RubenvanTonder/azoteq-logic-analyzer/pcb/A1/Reports/DRC/DT_AZP1524A1_PCB1_00A.html

Altium

# Design Rule Verification Report

Date: | | 2026/04/16
Time: | | 09:55:09
Elapsed Time: | | 00:00:00
Filename: | | C:\Users\Jason Reinecke\Desktop\AZP1524\A1\DT_AZP1524A1_PCB1_00A.PcbDoc

Warnings: | | 0
Rule Violations: | | 0

## Summary

Warnings | Count
Total | 0

Rule Violations | Count
Clearance Constraint (Gap=0.35mm) (((ObjectKind = 'Track') or (Objectkind = 'Arc')) And (Layer = 'KeepOutLayer') And (Width = AsMM(0.005))),(All) | 0
Clearance Constraint (Gap=0.3mm) (Innamedpolygon ('Top-GND') or Innamedpolygon ('Bot-GND')),(All) | 0
Clearance Constraint (Gap=0.1mm) (isvia),(onsoldermask) | 0
Clearance Constraint (Gap=0.2mm) (All),(All) | 0
Clearance Constraint (Gap=0.8mm) (hasfootprint('TEST-POINT-1.5MM')),(hasfootprint('TEST-POINT-1.5MM')) | 0
Clearance Constraint (Gap=0.5mm) ((ObjectKind = 'Track') And (Layer = 'KeepOutLayer') And (Width = AsMM(0.01))),(All) | 0
Short-Circuit Constraint (Allowed=No) (All),(All) | 0
Un-Routed Net Constraint ( (All) ) | 0
Power Plane Connect Rule(Relief Connect )(Expansion=0.5mm) (Conductor Width=0.35mm) (Air Gap=0.25mm) (Entries=4) (Disabled)(Ispad) | 0
Power Plane Connect Rule(Direct Connect )(Expansion=0.508mm) (Conductor Width=0.254mm) (Air Gap=0.254mm) (Entries=4) (Disabled)(Isvia) | 0
Hole Size Constraint (Min=0.3mm) (Max=4mm) (Disabled)(All) | 0
Hole To Hole Clearance (Gap=0.3mm) (All),(All) | 0
Silk To Solder Mask (Clearance=0.1mm) (isdesignator),(onsoldermask) | 0
Net Antennae (Tolerance=0mm) (All) | 0
Vias Under SMD Constraint (Allowed=Not Allowed) (All) | 0
Total | 0
