RubenvanTonder/azoteq-logic-analyzer/maximum square wave frequency measurable.jpeg

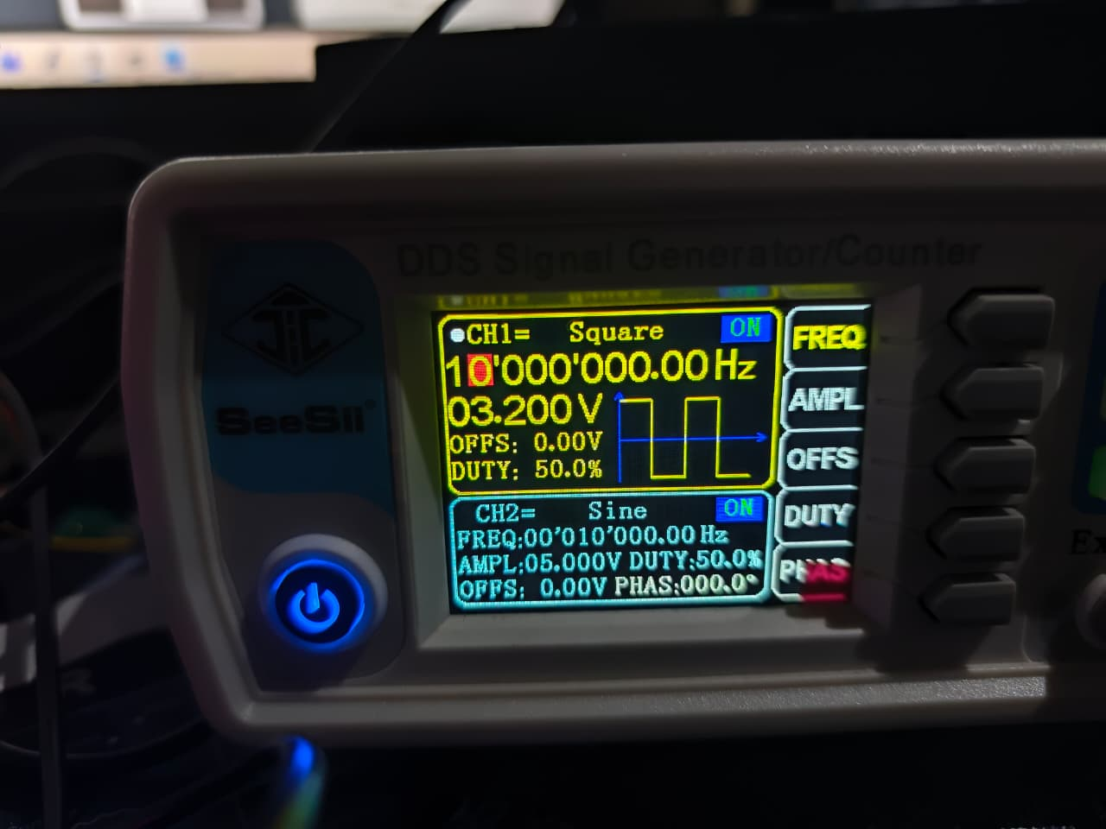
maximum square wave frequency measurable.jpeg
