RubenvanTonder/azoteq-logic-analyzer/Photos/75ns.png

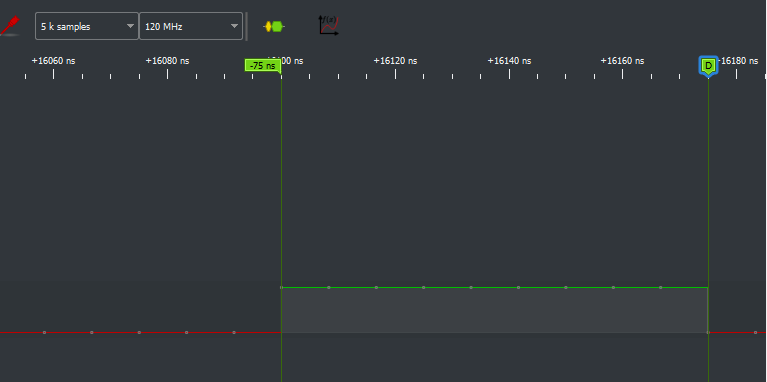
Photos/75ns.png
