RubenvanTonder/azoteq-logic-analyzer/Photos/166ns.png

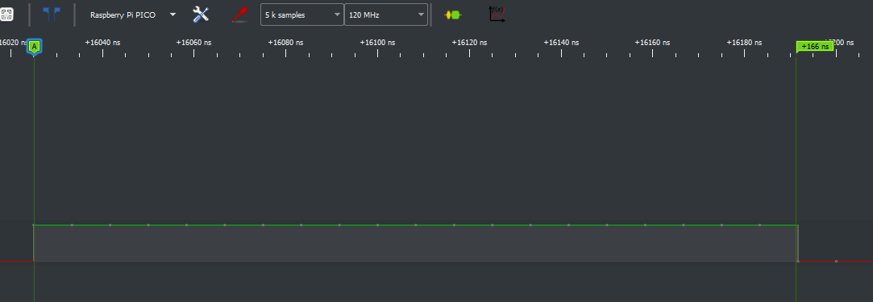
Photos/166ns.png
