RubenvanTonder/azoteq-logic-analyzer/Photos/268ns.png

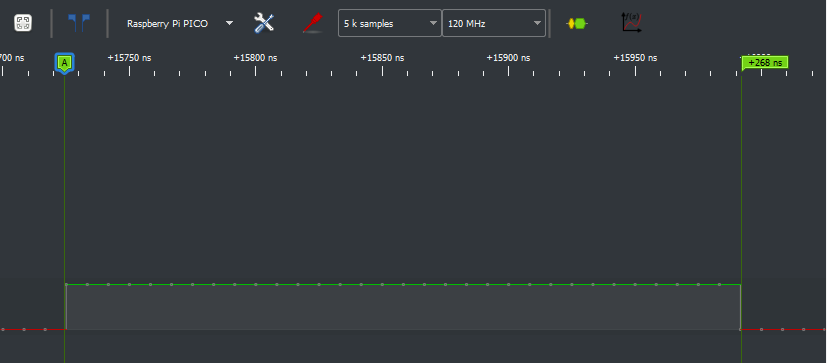
Photos/268ns.png
