RubenvanTonder/azoteq-logic-analyzer/Photos/368ns.png

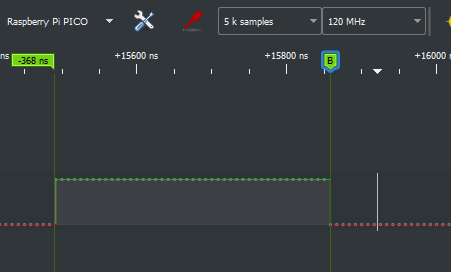
Photos/368ns.png
