RubenvanTonder/azoteq-logic-analyzer/Photos/470ns.png

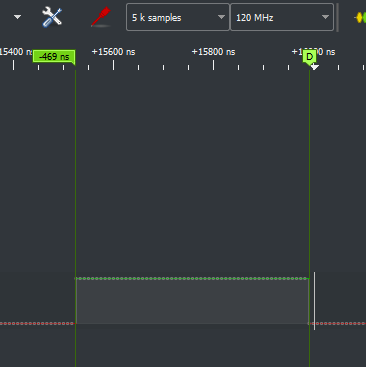
Photos/470ns.png
