RubenvanTonder/azoteq-logic-analyzer/trigger_level.jpeg

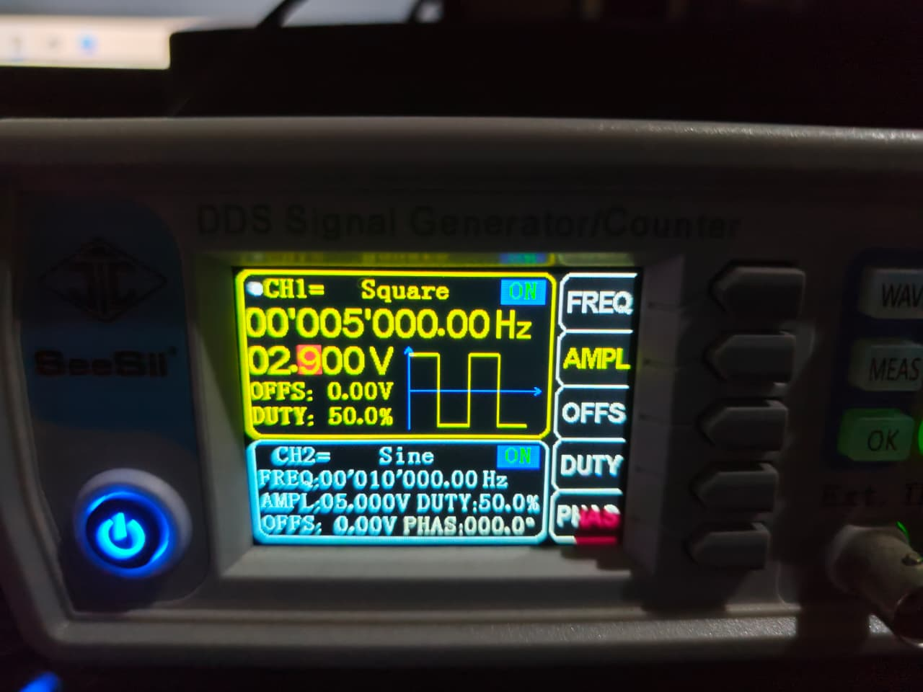
trigger_level.jpeg
