RubenvanTonder/azoteq-logic-analyzer/pcb/A1/Reports/BOM/BOM/[Bill of materials]-AZP1524A1.xlsx

Name | Description | Designator | Footprint | Int_Part_Number | LibRef | Quantity | Manufacturer | Manufacturer_PN | Layer
1uF | Capacitor, Ceramic, 1uF, 0603, X5R, 10%, 10V | C1, C4, C6, C7 | C-0603 | CAP0021 | CAP 1u0F 0603 CER X5R 10% 10V | 4 | Samsung | CL10A105KP8NNNC | Top
10uF | Capacitor, Ceramic, 10uF, 0603, X5R, 20%, 6V3 SAMSUNG | C2, C5 | C-0603 | CAP0076 | CAP 10uF 0603 CER X5R 20% 6V3 SAMSUNG | 2 | SAMSUNG | CL10A106MQ8NNNC | Top
100nF | Capacitor, Ceramic, 100nF, 0603, X7R, 10%, 50V | C3 | C-0603 | CAP0032 | CAP 100nF 0603 CER X7R 10% 50V | 1 | Samsung | CL10B104KB8NNNC | Top
NSR0320MW2T1G | Diode Schottky 20V 1A 2-Pin SOD-323 T/R | D1 | D-SOD-323 | DIO0074 | Diode Schottky 20V 1A SOD-323 | 1 | ONsemiconductors | NSR0320MW2T1G | Top
LM4041DID |  | D2 | SOT-23 |  | DIODE-ZENER-LM4041-SOT-23 | 1 | Texas Instruments | LM4041DIDBZTG4 | Top
KPT-1608ID |  | DS1 | D-LED-RED-0603 |  | LED-KPT1608ID-RED-0603 | 1 | KingBright | KPT-1608ID | Top
WEJT61BC-D76 | LED, WEJT61BC-D76, Blue, Vf=3.2V , If=30mA | DS2 | D-LED-BLUE-0603 - WEJ updated | LED0098 | LED-WEJT61BC-D76-BLUE-0603 | 1 | WEJ | WEJT61BC-D76 | Top
USB4500-03-0-A | USB-C TYPE REC 16P, 3U" MID MNT 0.8MM USB2.0 | J1 | J-USB-GCT-USB4500-03-0-A | NONE | USB-GCT-USB4500-03-0-A | 1 | GCT | USB4500-03-0-A | Top
HEADER-10W | Connector, Header, Edge Mount,DIL, 10W, SMT | P5 | P-BERG-10W-HDR-EDGE |  | BERG-10W-HDR-EDGE | 1 |  |  | Top
8W-SIL-RA | Connector, Header, Right angle, SIL, 8W, THP | P6 | P-BERG-8W-HDR-RA-SIL |  | BERG-8W-HDR-RA-SIL | 1 | Ho Chien |  | Top
AZP1524A1 | PCB | PCB1 |  | MNFPCB | PCB - AZCxxxA01 | 1 |  | AZP1524A1 | None
 | Resistor, 0603, 5%, 0.1W | R1, R3, R5, R6, R8 | R-0603 | MNFR04 | MNFR 0603 5% 0.1W | 5 |  |  | Top
DNP | Resistor, DNP, 0603 | R2, R7, R9, R10, R13 | R-0603 | DNP | RES DNP 0603 | 5 |  |  | Top
470R | Res Thick Film 0603 470 Ohm 5% 0.1W(1/10W) ±100ppm/°C Molded SMD Paper T/R | R4 | R-0603 | RES0307 | RES 470R 0603 5% 0.1W Yageo | 1 | Yageo | RC0603JR-07470RL | Top
0R | Res Thick Film 0603 0 Ohm Molded SMD Paper T/R | R11 | R-0603 | RES0139 | RES 0R 0603 1% 0.1W Yageo | 1 | Yageo | RC0603JR--070R | Top
0.5A POLYSWITCH | Polyswitch, nanoSMDC050F, 1206, 0.5A, 13.2V | R12 | R-POLYSWITCH-1206 | SWT0070 | POLYSWITCH-nanoSMDC050F/13.2 | 1 | Tyco | nanoSMDC050F/13.2 | Top
5K1 | Resistor, 0603, 1%, 0.1W | R14, R15 | R-0603 | MNFR03 | MNFR 0603 1% 0.1W | 2 |  |  | Top
22R | Resistor, 0603, 1%, 0.1W | R16, R17 | R-0603 | MNFR03 | MNFR 0603 1% 0.1W | 2 |  |  | Top
GABOU-KFC-807 | SWITCH TACTILE SPST-NO 0.05A 12V | S1 | S-GABOU-KFC-807 |  | GABOU-KFC-807 | 1 | GABOU | KFC-807 | Top
OS103011MS8QP1 | SWITCH SLIDE SP3T 100MA 12V | S2 | S-C&K-OS103011MS8QP1 |  | C&K-OS103011MS8QP1 | 1 | C&K | OS103011MS8QP1 | Bottom
AZP1159C1 | AZP115C01: RP2350 Stamp (Pi Pico) - stamp breakout | U1 | AZP1159C1 | NONE | AZP1159C1 | 1 | Azoteq | AZP1159C1 | Top
AMS1117-3.3V | IC, Voltage Regulator, 3.3V Out, 4.7-18V In, 1A | U2 | SOT-223 | NONE | AMS1117-MSKSEMI-SOT-223 | 1 | MSKSEMI | AMS1117-3.3V | Top
AP2138N-1.8TRG1 | IC REG LINEAR 1.8V 250MA SOT23-3 | U3 | SOT-23 |  | AP2138N-1.8TRG1-SOT-23 | 1 | Diodes Incorporated | AP2138N-1.8TRG1 | Top
SN74LVC8T245PW |  | U4 | U-TSSOP-24 |  | SN74LVC8T245PW-TSSOP-24 | 1 | Texas Instruments | SN74LVC8T245PWG4 | Top
