RubenvanTonder/azoteq-logic-analyzer/pcb/A1/CAD/STEP & PARASOLID FILES/DT_AZP1524A1_PCB1_00A.step

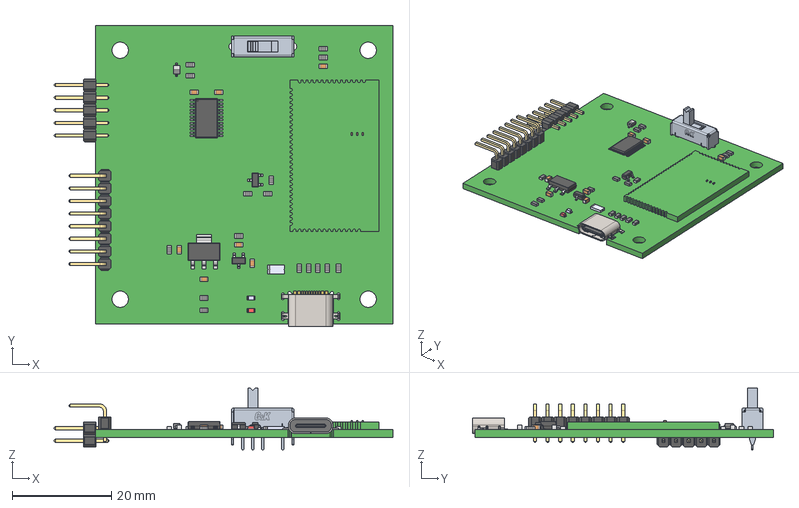
[picture p13: CAD file, 2026-05-11]
pcb/A1/CAD/STEP & PARASOLID FILES/DT_AZP1524A1_PCB1_00A.step
68.3 x 60.7 x 12.5 mm
R-0603 x 16
USB4500-C_Body
USB4500-C_ConnPlate
USB4500-C_Pins
U-TSSOP-24
User_Library-Chip_Cap_MLCC_0201_(0603) x 3
SOT-23 x 2
SW3DPS-SOT-223-DEFAULT
OS103011MS8QP1
R-POLYSWITCH-1206
P-BERG-8W-HDR-RA-SIL
P-BERG-10W-HDR-V
D-LED-0603-BLUE
D-LED-0603-RED
SOD-323
C-0603 x 7
