RubenvanTonder/azoteq-logic-analyzer/(list of files, cad)

Other CAD files:
pcb/A1/CAD/STEP & PARASOLID FILES/DT_AZP1524A1_PCB1_00A.DXF
pcb/B1/CAD/STEP & PARASOLID FILES/DT_AZP1524A1_PCB1_00A.DXF
