RubenvanTonder/azoteq-logic-analyzer/Functional Tests.docx

1. Maximum Sample Rate Test

Verify the highest speed at which the hardware can reliably capture data without dropping bits.

- Method: Input a high-frequency square wave (e.g., from a signal generator).
- Goal: Ensure the captured waveform matches the input frequency without aliasing.
- Check: Verify the Shannon-Nyquist limit (sample at least 2x the input frequency). [1 (https://jpowcode.github.io/Basic%20functions.html)]

2. Pulse Width & Glitch Capture

Test the minimum pulse width the analyzer can detect. [1 (https://www.vinnie.work/docs/EmbeddedSystemsAnalysis/HardwareSignalsAnalysis/SerialAccessLab)]

- Method: Input a series of narrowing pulses (100ns, 50ns, 10ns, etc.).
- Goal: Identify the "blind spot" where the hardware fails to register a transition.
- Check: Confirm if the hardware can capture pulses shorter than the sample period. [1 (https://knimbus.wonderslate.com/wpmain/aibook?siteName=Wonderslate&bookId=95867)]

3. Multi-Channel Skew Test

Check for timing alignment issues between different input pins.

- Method: Send the same fast clock signal to all input channels simultaneously.
- Goal: Measure the time delta between the first and last channel registering the edge.
- Check: Ensure skew is within your design's tolerance (ideally <1 sample period).

4. Trigger Latency & Reliability

Ensure the analyzer starts recording exactly when the trigger condition is met. [1 (https://www.oemsecrets.com/articles/oscilloscopes-essential-tools-for-electrical-signal-analysis)]

- Method: Set a complex trigger (e.g., a specific I2C address or pattern) and measure the offset.
- Goal: Confirm the "trigger point" in the buffer aligns with the actual event.
- Check: Test "Pre-trigger" and "Post-trigger" buffer depth accuracy. [1 (https://articles.saleae.com/logic-analyzers/what-is-a-logic-analyzer), 2 (https://www.switchdoc.com/2019/10/using-a-logic-analyzer-for-fun-and-profit-raspberry-pi/)]

5. Threshold & Logic Level Stress

Validate the comparator or input buffer performance across voltage ranges.

- Method: Use a variable voltage source to find the exact high/low transition point.
- Goal: Verify the switching threshold matches your design (e.g., 1.8V, 3.3V, or 5V logic).
- Check: Test for "double-triggering" or noise on slow-rising edges (hysteresis check). [1 (https://docs.amd.com/api/khub/documents/ySaQRCY6Y5vUd8bI_TWSug/content)]

6. Sustained Data Throughput

Check for buffer overflows or USB/Interface bottlenecks.

1. Method: Capture a high-speed data stream (like an SPI flash read) for several seconds.
2. Goal: Ensure no data gaps occur during long-duration captures.
3. Check: Monitor for "Buffer Overflow" errors in your software or FPGA logic.
1. Maximum Sample Rate Test

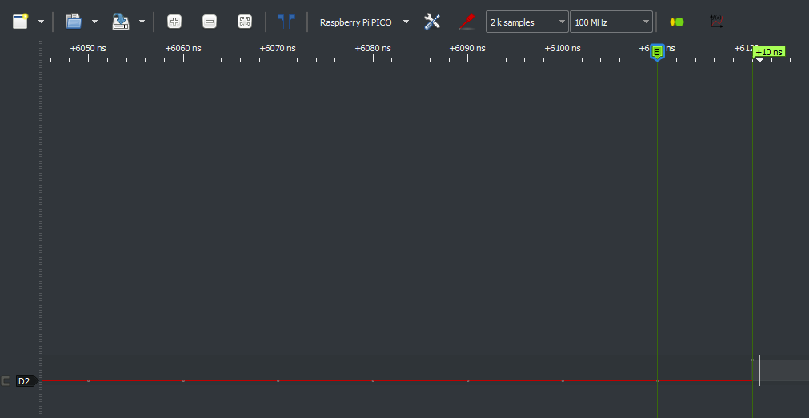
[picture p14: figure]

2. Threshold and Logic Trigger


3. Minimum Pulse Width

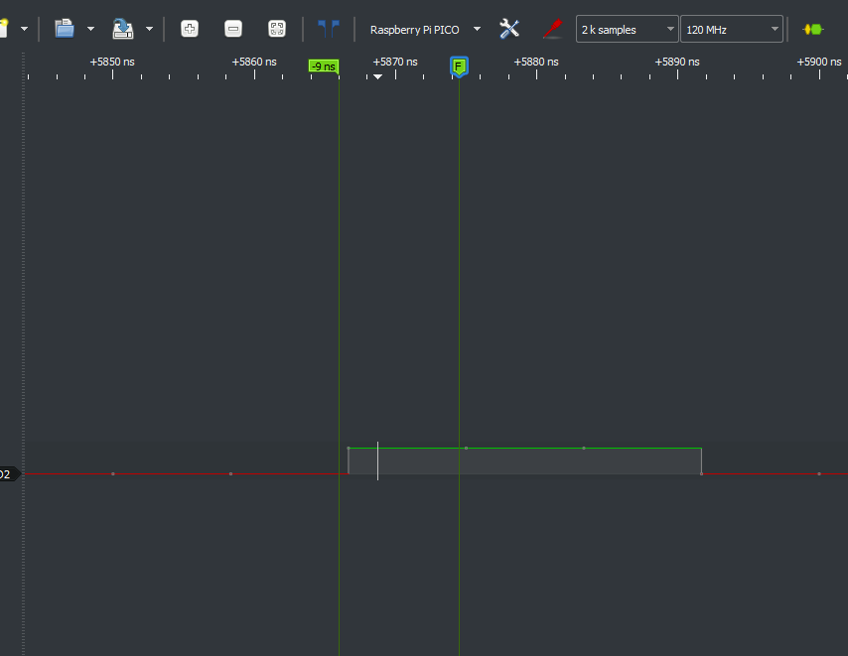
[picture p15: figure]

⏱️ Sampling & Frequency Tests

- Maximum Sampling Rate (Buffer):
  - Test: Generate a high-speed clock signal (e.g., 50MHz for DL16, 200MHz for Plus).
  - Validation: Use the Nyquist–Shannon sampling theorem (https://downloads.saleae.com/specs/Logic+Pro+16+Data+Sheet.pdf) as a guide. Your analyzer should sample at least 4x to 5x the signal frequency to accurately reconstruct it. If a 50MHz signal looks like a random mess or a much slower clock, you've hit an aliasing limit.
- Minimum Detectable Pulse Width:
  - Test: Create a very narrow pulse (glitch) using a PWM generator. Gradually decrease the width from 20ns down to your target (8ns or 2ns).
  - Validation: The analyzer "validates" this if it can consistently trigger on and display the pulse without it disappearing between samples. [1 (https://www.electronics-notes.com/articles/test-methods/logic-analyzer/specifications.php), 2 (https://downloads.saleae.com/specs/Logic+Pro+16+Data+Sheet.pdf), 3 (https://myembeddedstuff.com/best-logic-analyzers-in-2026)]

💾 Storage & Data Mode Tests

- Hardware Storage Depth:
  - Test: Set the analyzer to its maximum sampling rate and trigger a long, continuous data stream (like a fast UART or SPI burst).
  - Validation: Calculate the expected time: (Total Bits) / (Sample Rate * Channels). If you have 1Gbit of storage and sample 16 channels at 100MHz, you should capture about 0.625 seconds of data. If it stops early, your buffer management or RLE compression is failing.
- Stream Mode (Computer Memory):
  - Test: Set a lower sample rate (e.g., 20MHz) and record for several minutes.
  - Validation: Monitor your PC's RAM usage. The analyzer should continuously "stream" data over USB without dropping samples or crashing the software. [1 (https://electronics.stackexchange.com/questions/103857/understanding-sampling-rate-and-frequency-of-logic-analysers)]

⚡ Electrical & Signal Integrity

- Input Impedance (250kΩ/15pF):
  - Test: Connect a 100kΩ resistor in series with your signal source and the analyzer input.
  - Validation: Measure the voltage at the analyzer's pin with a high-impedance scope. If the voltage drops significantly, your input impedance is too low, which will "load" and distort the circuit you are testing.
- Adjustable Threshold:
  - Test: Feed a 3.3V signal into the analyzer. Set your threshold to 1.0V, then 2.5V, then 3.0V.
  - Validation: At 1.0V, the signal should look normal. At 3.0V, it should either show as a constant "Low" or be highly jittery, confirming the threshold is actually moving. [1 (https://www.eevblog.com/forum/beginners/increasing-logic-analyzer-input-impedance/), 2 (https://articles.saleae.com/logic-analyzers/choosing-a-logic-analyzer), 3 (https://www.saleae.com/support/protocol-analyzers/analyzer-user-guides/decode-differential-and-high-voltage-data)]

🔍 Protocol & Triggering

- Trigger Accuracy:
  - Test: Set a "Falling Edge" trigger on a specific pin and a "Value" trigger on a protocol (e.g., trigger when I2C address 0x42 appears).
  - Validation: The capture should start exactly at that event. If the data starts 10ms after the event, your trigger logic has a timing violation or latency issue (https://semiwiki.com/eda/362304-min-pulse-width-timing-check-the-silent-timing-trap-lurking-in-every-sub-5nm-design/).
- Protocol Decoding (170+):
  - Test: Use a known-good device (like an Arduino (https://learn.arduinosa.co.za/arduino-introduction) or Raspberry Pi) to send standard UART, I2C, and SPI messages.
  - Validation: Compare the analyzer's decoded text/hex output to the code you wrote. Any mismatch indicates a sampling jitter or decoding software bug
