RubenvanTonder/azoteq-logic-analyzer/pcb/A1/Plots/AZP1524A1 [Top & Bot Assembly].PDF

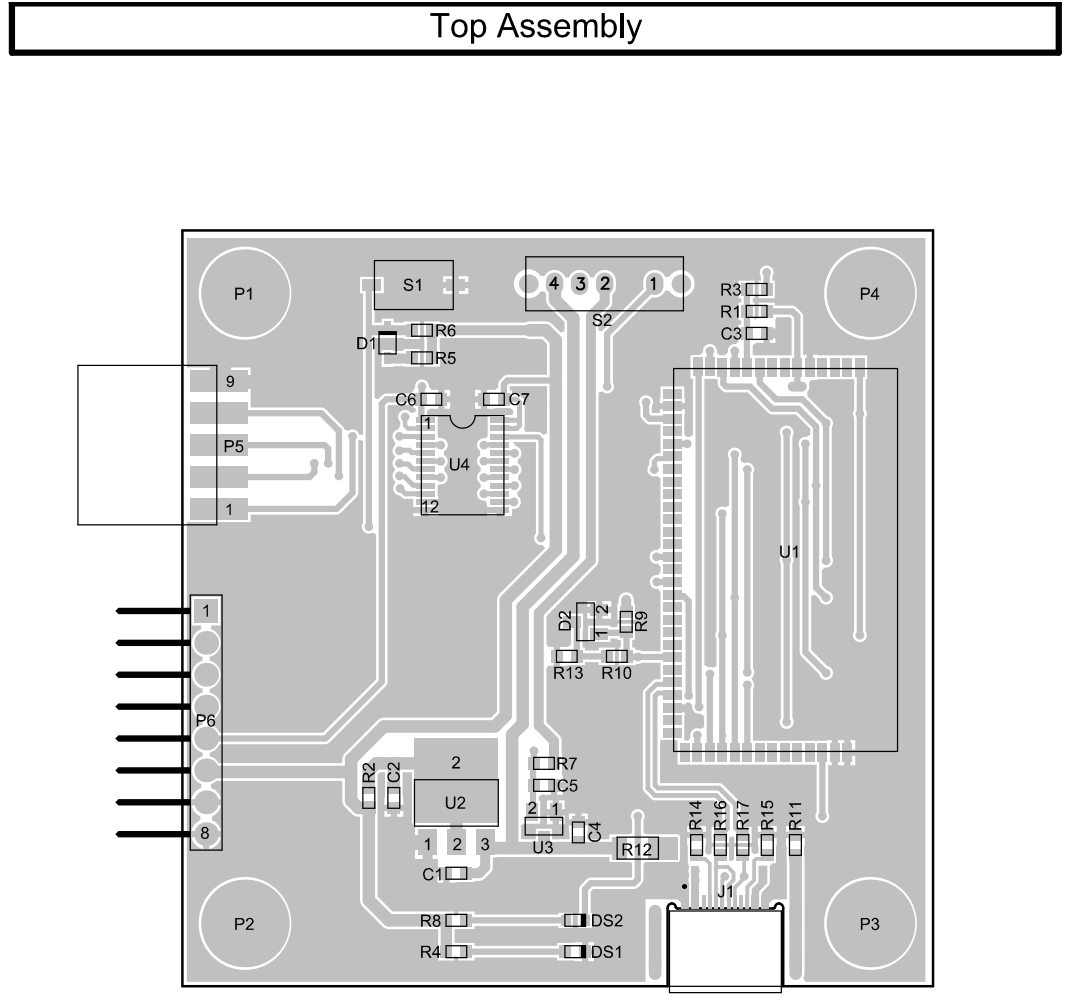
[picture p16: page 1]

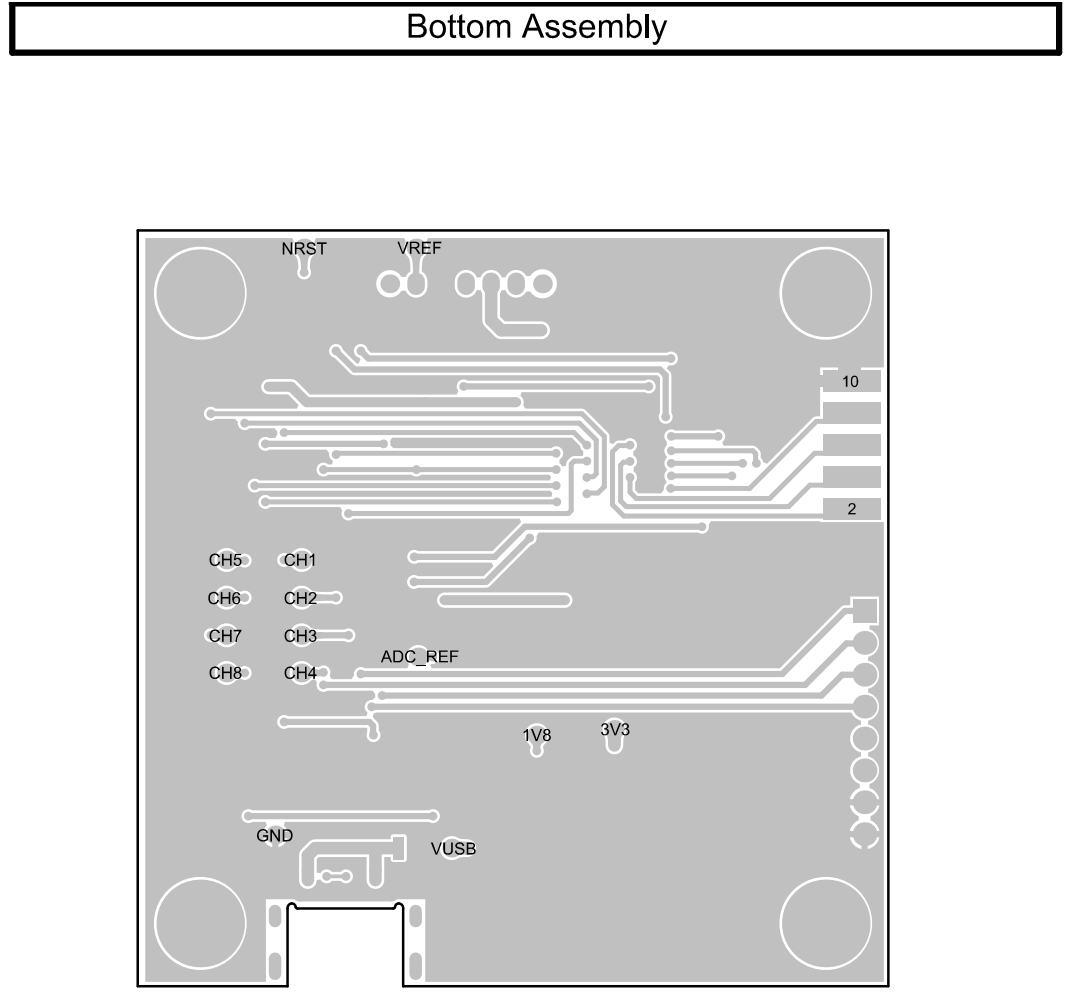
[picture p17: page 2]
