RubenvanTonder/azoteq-logic-analyzer/pcb/A1/Plots/AZP1524A1 [Gerber layers - Manuf & Drill].PDF

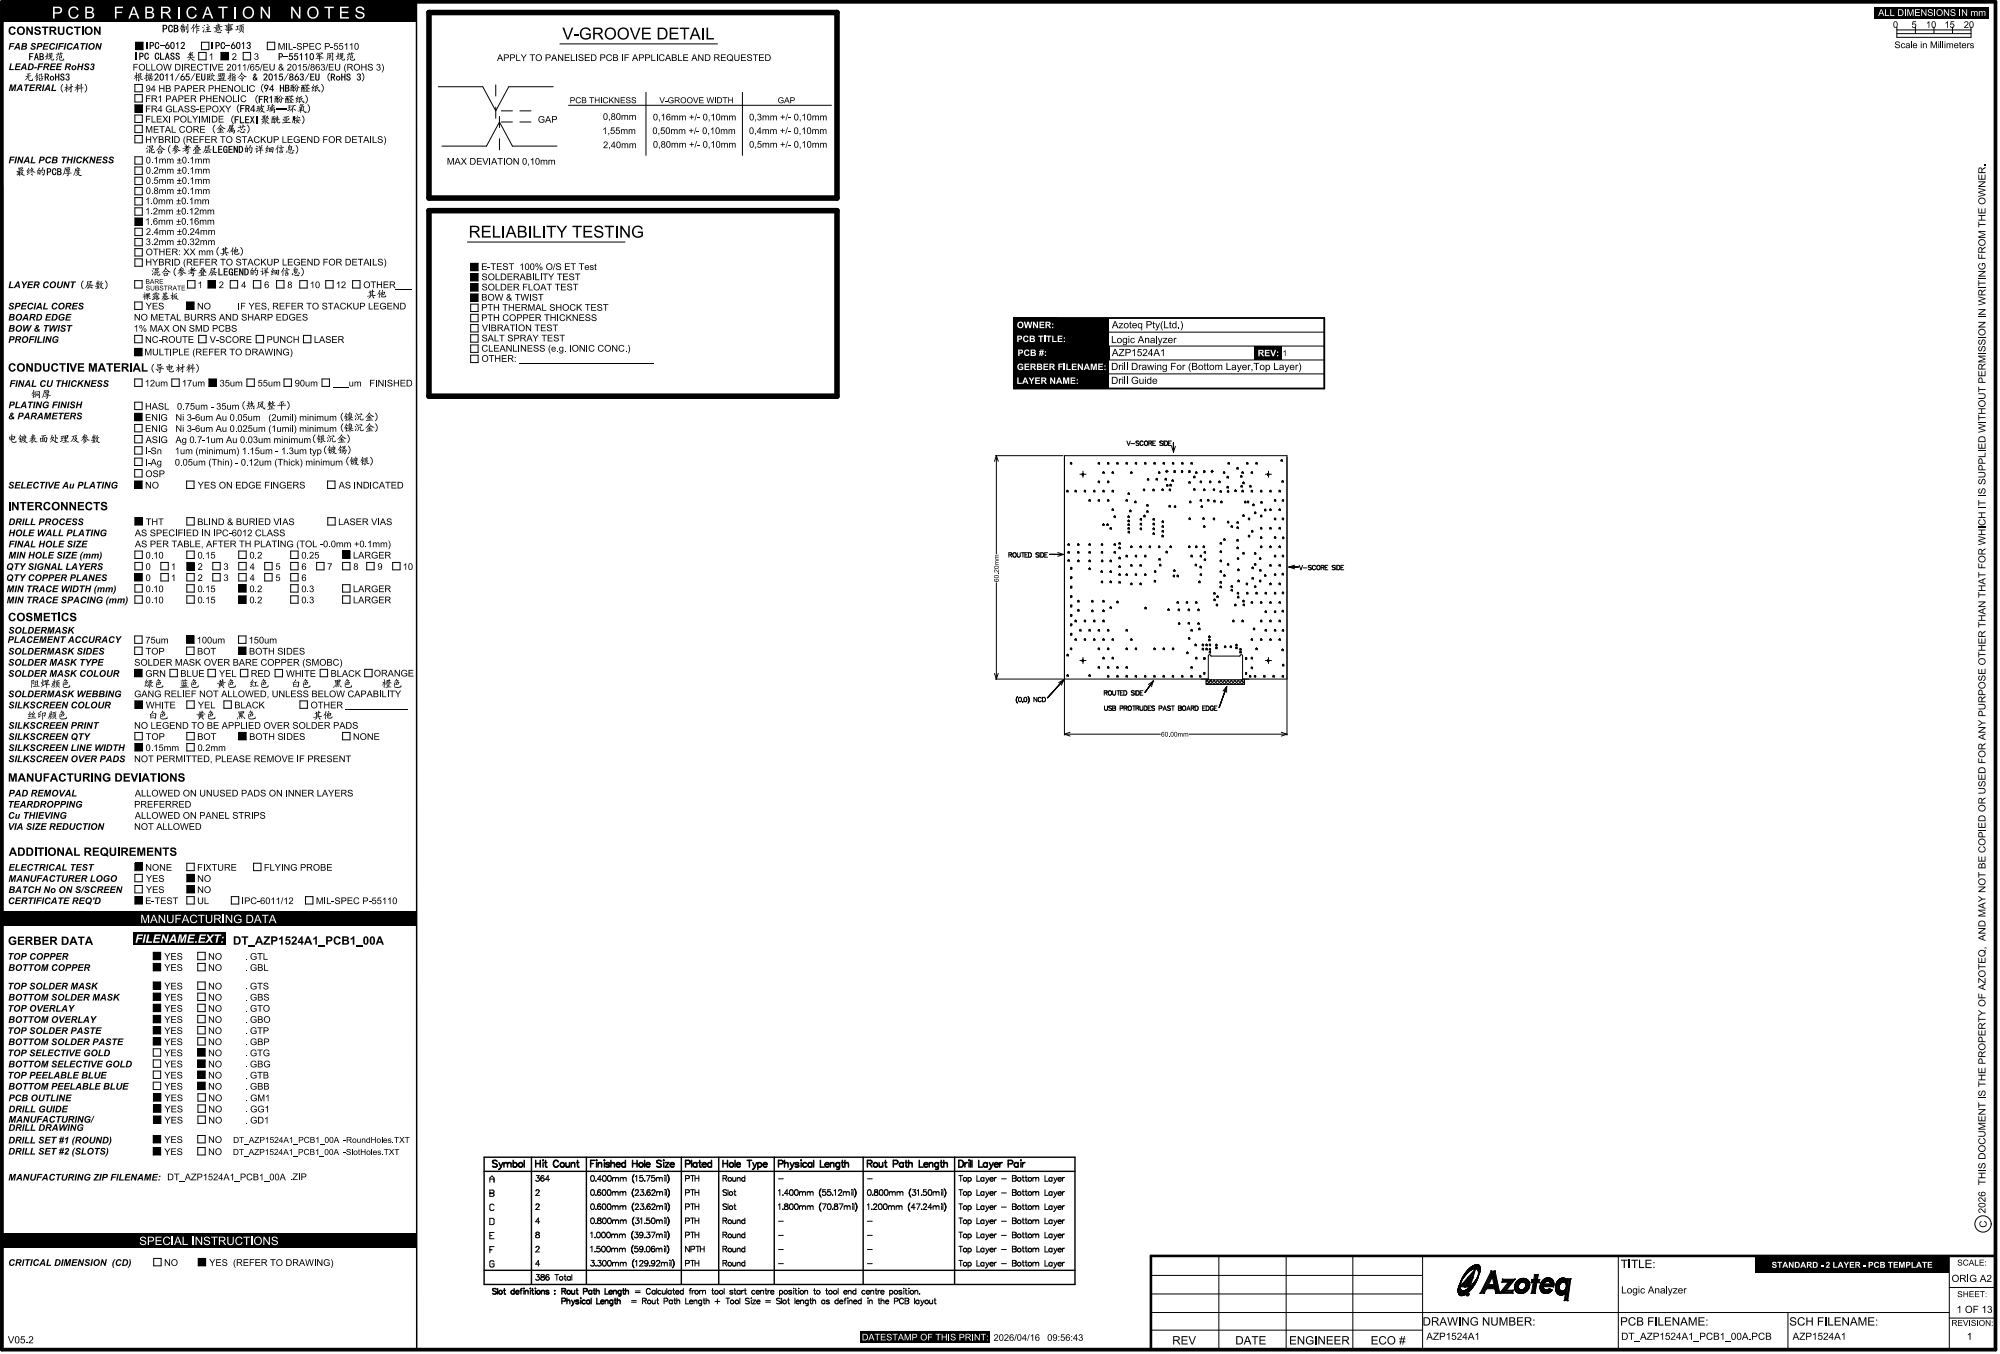
[picture p18: page 1]
