RubenvanTonder/azoteq-logic-analyzer/(list of files, drawings)

Other design files:
pcb/A1/AZP1524A1.PrjPCB
pcb/A1/DT_AZP1524A1_PCB1_00A.PcbDoc
pcb/A1/DT_AZP1524A1_SCH1[SHEET1]_00A.SchDoc
pcb/A1/DT_AZP1524A1_SCH1[SHEET2]_00A.SchDoc
pcb/B1/AZP1524B1.PrjPCB
pcb/B1/DT_AZP1524B1_PCB1_00A.PcbDoc
pcb/B1/DT_AZP1524B1_SCH1[SHEET1]_00A.SchDoc
pcb/B1/DT_AZP1524B1_SCH1[SHEET2]_00A.SchDoc
