RubenvanTonder/azoteq-logic-analyzer/pico_sdk_sigrok/sr_device.h

#ifndef SR_DEVICE_H
#define SR_DEVICE_H
#include <stdint.h>
#include <stdbool.h>
#include "pico_sdk_sigrok.h"
#include "AZP1524A1.h"

// Pin usages
///////////////////////////////////
// Baseline mode -21 digital, 3 analog
// GP0,1 is debug uart TX, RX (but rx not used)
// GP2-GP22 are digital inputs
// GP23 controls power supply modes and is not a board I/O
// GP24 is a power sense and not a board I/O
// GP25 controlls the LED and is not a board I/O
// GP26-28 are ADC. (Only 7 bit accuracy supported)
//////////////////////////////////
// Digital 26 Mode
// GP0-GP22 are digital inputs
// GP23 controls power supply modes and is not a board I/O
// GP24 is a power sense and not a board I/O
// GP25 controlls the LED and is not a board I/O
// GP26-28 are digital.
////////////////////////////
// Digital 32 Mode
// Use GPIO 0..31 for boards that export those pins
// No uart, no ADC, LED, power supply control or power sense etc.
/////////////////////////
// Note: In the wireless versions, GPIO23-25 control the wifi chip, 23 and 24
//aren't available in the PICO, and 25 controls the LED. So while the LED is lost,
//there is no change in available channels for sampling.
//WARNING: USE PIN_TEST_MODE with extreme caution!!!!
//If set, treat the inputs (A&D) to be outputs so that the device can drive values for
//turn-on testing.  Enabling this allows all modes to be tested without having to drive
//test patterns on the chip.  But it turns what are normally inputs to outputs and thus
//can cause drive fights if any drivers are connected.
// //#define PIN_TEST_MODE 1
// #undef BASE_MODE
// #undef DIG_26_MODE
// #undef DIG_32_MODE
//These two enable debug print outs of D4 generation, D4_DBG2 is higher verbosity
//#define D4_DBG 1
//#define D4_DBG2 2

// Storage size of the DMA buffer.  The buffer is split into two halves so that when the first
// buffer fills we can send the trace data serially while the other buffer is DMA'dinto
#ifdef PICO_RP2350
 #define DMA_BUF_SIZE 476000 //add the full 256KB increase
#else
 #define DMA_BUF_SIZE 220000
#endif
// The size of the buffer sent to the CDC serial
// The TUD CDC buffer is only 256B so it doesn't help to have more than this.
#define TX_BUF_SIZE 260
//Setting to default value of Raspberry PI debug probe of 115200
#define UART_BAUD 115200 //921600
// This sets the point which we will send data from the txbuf to the usb cdc.
// For the 5-21 channel RLE it must leave a spare ~83 entries to cover the case where
// a new long steady input comes after deciding to not send a sample.
//(Assuming 128KB samples per half, a max rle value of 1568 we can get
//   256*1024/2/1568=83 max length rles on a steady input).
// Other than that the value is not very specific because the usb tub code
// implement a 256 entry fifo that queues things up and sends max length 64B transactions
// 20 is arbitrarly picked to ensure that if we have even a little we send it so that
// at least something goes across the link.
#define TX_BUF_THRESH 20
typedef enum  {IDLE = 0, //initial and ending condition, also cleanup variables used when not idle
              STARTED = 1, //the host has sent a command to start sending samples
              SENDING = 2, //the dma engines etc are configured and running
              DMA_DONE = 3, //DMA engine has sent all expected loop and is disabled
              SAMPLES_SENT = 4, //all samples have been sent to the host
              ABORTED = 5 //an error , usually DMA buffer overflow, has occured
            } dev_state;
typedef struct
{
   uint32_t sample_rate;
   uint32_t num_samples;
   uint32_t a_mask, d_mask;
   // number of samples for one of the 4 dma target arrays.  While this normally is related to the
   //half buffer sizes, in the optimized sending mode the value is temporarily overrided to adjust
   //the number of samples sent by the send_slice* functions.
   uint32_t samples_per_half;
   uint8_t a_chan_cnt;        // count of enabled analog channels
   uint8_t d_chan_cnt;        // count of enabled digital channels
   uint8_t d_tx_bps;          // Digital Transmit bytes per slice
   // Pins sampled by the PIO - 4,8,16 or 32
   uint8_t pin_count;
   uint8_t d_nps; // digital nibbles per slice from a PIO/DMA perspective.
   uint32_t scnt; // number of samples sent
   char cmdstrptr;
   char cmdstr[20];                                             // used for parsing input
   uint32_t d_size, a_size;                                     // size of each of the two data buffers for each of a& d
   uint32_t dbuf0_start, dbuf1_start, abuf0_start, abuf1_start; // starting memory pointers of adc buffers
   char rspstr[20];
   // mark key control variables voltatile since multiple cores might access them
   volatile dev_state state;
   volatile bool cont;
   //a "+" was received from the host telling us to stop
   //this could be seen in continuous mode (host is stopping)
   //or in fixed mode (after an abort or because the host felt like it)
   //It is not a state machine state as it is somewhat asyncronous to the state
   //and could interfere with the normal orderly progression through the FSM.
   volatile bool usb_plus;
   /*Depracated trigger logic
   //If HW trigger enabled, uncomment all usages
   //volatile bool notfirst;  //Have we processed at least a first sample (so that lval is correct
   //  volatile bool triggered;
   //  uint32_t tlval; //last digital sample value - must keep it across multiple calls to slices for trigger
   //  uint32_t lvl0mask,lvl1mask,risemask,fallmask,chgmask;
   End depracated trigger logic*/
} sr_device_t;

// Send to debug uart
int Dprintf(const char *fmt, ...);

// Process incoming character stream
int process_char(sr_device_t *d, char charin);

// reset as part of init, or on a completed send
void reset(sr_device_t *d);

// initial post reset state
void init(sr_device_t *d);

// Initialize the tx buffer
void tx_init(sr_device_t *d);

// Process incoming character stream
// Return 1 if the device rspstr has a response to send to host
// Be sure that rspstr does not have \n  or \r.
int process_char(sr_device_t *d, char charin);

#endif /* SR_DEVICE_H */
