RubenvanTonder/azoteq-logic-analyzer/(commit log)

2026-04-14 Fix issue with accidently pushing wrong repo
    [sr_device.c]
2026-04-15 Feat: Added the correct pinout for the Azoteq PCB
    style(pico_sdk_sigrok): remove trailing whitespace and reformat comments
    This commit removes trailing whitespace from source code and comment lines
    throughout pico_sdk_sigrok.c. Several comment blocks have been reflowed for
    better readability and consistency. The binary uf2 file was regenerated as
    part of the build process after these formatting changes.
    [pico_sdk_sigrok.c, sr_device.h]
2026-04-17 fix(rp2350): correct BASE_MODE ADC and digital pin configuration
    Update GPIO pin mappings for RP2350 BASE_MODE to use correct pins:
    - ADC channels now map to GP41, GP42 instead of GP26, GP27
    - Digital channels D0-D7 now map to GP2-GP9 instead of GP2-GP22
    - Add explicit pin definitions (ADC1, ADC2, D1-D8) in sr_device.h
    - Update adc_gpio_init calls to use correct pin numbers
    This ensures proper hardware pin configuration for the logic analyzer on RP2350.
    [pico_sdk_sigrok.c, sr_device.c, sr_device.h]
2026-04-20 Feat: Modified code to add the ability to toggle the LED, updated the firmware upgrader to remove unnecessary pin identification, added led button
2026-04-21 feat(pwm): add PWM initialization and helper functions for Azoteq
    Extracts common includes into a dedicated header to improve maintainability.
    Adds hardware_pwm dependency and initializes PWM slices when enabled.
    Introduces set_pwm_level() and update_pwm_frequency() for dynamic control.
    Enables required PWM functionality for the custom Azoteq Logic Analyzer PCB.
2026-04-21 feat(pwm): enable dynamic frequency and duty cycle configuration
    Update firmware to parse W<channel>,<freq_khz>,<duty_pct> commands instead of hardcoded values. Add unit conversion (kHz to Hz, percent to 0-1 decimal) and input validation for robust parameter handling.
    Modify Python GUI to replace static PWM buttons with editable frequency and duty cycle fields, dynamically passing the user-defined values to the device via the new command format. Enables real-time adjustment of PWM settings directly from the host application.
    [firmware_upgrade.py, sr_device.c]
2026-04-22 feat: support dual PWM outputs and dynamic frequency calculation
    Refactor update_pwm_frequency to dynamically calculate the PWM wrap
    value based on target frequency, preventing fixed pulse widths when
    adjusting clock speed. Added hardware constraints for clock divider
    and wrap limits.
    Update device header to remap PWM2 from GPIO 13 to 14. Configure
    initialization for both PWM1 and PWM2 slices with independent clock
    dividers to support multi-channel signal generation.
    [pico_sdk_sigrok.c, sr_device.h]
2026-04-30 Fix: Fixed double use of GPIO14 and correct initialization of DIR and NOT_OE GPIO pins
    [pico_sdk_sigrok.c, sr_device.h]
2026-04-30 Feat: Add AZP1524A1 h-file for PCB specific GPIO assigning and added function test doc
2026-05-01 Feat: Updated ADC Clock for 300MHz
2026-05-04 fix(pico-sdk): lower sys clock to 200MHz and update core1 pin test logic
    - Reduce system clock from 300MHz to 200MHz to improve stability and compatibility
    - Update PWM initialization to use the new PWM macro instead of PWM1
    - Implement core1_entry() for PIN_TEST_MODE with proper GPIO setup, repeating timer, and __wfe() loop to reduce memory bus contention
    - Move systick array clearing into the main loop and remove redundant hardware includes
    - Update local VSCode configuration path and rebuild firmware binary
    [AZP1524A1.h, pico_sdk_sigrok.c, pico_sdk_sigrok.h]
2026-05-06 Started working on B1 of the PCB
    [AZOTEQ TEMPLATE Bill of Materials-AZP1524A1.xlsx, AZP1524A1.PrjPCB, AZP1524B1.PrjPCB, DT_AZP1524A1_PCB1_00A.DXF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]
2026-05-07 Feat: Added tasks.json file,; Added Example Documentaion and SpecificationsDocumentation markdown files, changed pico_sdk_sigrok.c to make use of default 125MHz clock instead of 200MHz found issues w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
    [pico_sdk_sigrok.c]
2026-05-07 Feat: Improved the tasks.json file by adding a build and upload task, changed adc code to automatically get the clock frequency for its calculations
2026-05-07 Fix: Corrected ADC issue where only one channel works at a time by increase the buffer size and making the round robbin start at the correct place
    [pico_sdk_sigrok.c]
2026-05-07 Refactor: Added some code don;'t think it does anything ADCREF at 1.2V instead of 3.3V hardware issue
    [pico_sdk_sigrok.c]
2026-05-08 Feat: Added Python GUI to use PWM and ADC functionality independent from pulseview
2026-05-08 Feat: Added python API but it does not work yet, it connects to the device but does not save the data
    [GUI_ADC_PWM.py, capture.py, device.py, example.py, save.py]
2026-05-12 Fix: Changed ADC mask to only have 1 channel, there is an issue when using two or more channels due to voltage leftover in caps from switching between the two channels
    [pico_sdk_sigrok.c]
2026-05-16 Updated Schematic
    [DT_AZP1524B1_PCB1_00A.PcbDoc, DT_AZP1524B1_SCH1[SHEET2]_00A.SchDoc]
2026-05-16 Added RGB LED
    [DT_AZP1524B1_PCB1_00A.PcbDoc, DT_AZP1524B1_SCH1[SHEET2]_00A.SchDoc]
